Phoenix1o1/ThermoMade/docs/04-control-algorithm.md

# 04 — Control algorithm (specification)

The firmware must implement exactly this. The Python reference implementation lives in
`tools/sim/thermal_sim.py` (`PID`, `PulseModulator`, `TermoMade`), so firmware and simulator
can be checked against each other.

## Layers

```mermaid
flowchart LR
  T["Sensor readings"] --> M["Measurement<br/>plausibility + EMA filter"]
  SP["Setpoint<br/>(mode / schedule)"] --> PI
  M --> PI["PI(D)<br/>u ∈ [0,1]"]
  FF["Feed-forward<br/>(outdoor, future)"] -.-> PI
  PI --> MOD["Pulse modulator<br/>u → ON/OFF targets"]
  MOD --> FSM["Valve FSM<br/>enforces ON_MIN / OFF_MIN"]
  G["Gates: plant hours,<br/>mode OFF, faults"] --> FSM
  FSM --> RELAY["Relay"]
```

`u` is the **demand**: the fraction of time the valve should be open (duty), from 0 to 1.

## 1. Measurement & sensor fusion

- Room node telemetry every 30 s (SHT4x, 0.01 °C). CYD local DS18B20 read every 30 s
  (12-bit, 0.0625 °C).
- **Plausibility:** reject T < 0 °C or > 40 °C, or |ΔT| > 2 °C between consecutive readings.
  Three rejections in a row = sensor failure.
- **Calibration offset** per sensor, set in the UI against a reference thermometer. The room node
  is the reference by default.
- **Learned CYD offset.** The CYD sensor sits in a box with a PSU and an ESP32, so it reads warm by
  a slowly varying amount:
  ```
  if both valid and |dT_room/dt| < 0.5 °C/h:          # quasi-steady only
      off_b += dt/(τ_off+dt) · ((T_base − T_room) − off_b)     τ_off = 6 h
  T_base_corr = T_base − off_b
  ```
  `off_b` is persisted to NVS hourly. Watch it on the diagnostics screen. If it moves a lot with
  the backlight on/off, the sensor chamber needs work.
- **Fusion** (policy `FUSED`): `T = w_r·T_room + (1 − w_r)·T_base_corr`, `w_r = 0.7` default.
  Two sensors in different spots of the big room give a better room average and halve the
  uncorrelated noise.
- **Fallback:** room node lost → `T = T_base_corr` (frozen `off_b`). CYD sensor lost →
  `T = T_room`. Both lost → LIMP (§6).
- **EMA filter** with τ_f = 120 s on the fused value: `Tf += dt/(τ_f+dt) · (T − Tf)`.
- Other policies (bathroom etc.) in [03](03-architecture.md#control-temperature--room-policies).

## 2. PI(D) → demand u

Runs every `TS` = 30 s (fixed tick, real `dt` from a monotonic clock).

```
if SP < SP_prev:  coast = true          # setpoint decreased (e.g. Comfort → Night)
e  = SP − Tf
if e ≥ 0:         coast = false         # room has cooled down to the new setpoint
P  = Kp · e
D  = −Kp · Td · dTf/dt                  # derivative on measurement, low-pass τ = Td/4; Td = 0 by default
u_unsat = P + I + D
if |e| ≤ I_BAND and not coast and not (u_unsat ≥ u_max and e > 0):
    I += Kp · dt / Ti · e               # integrate only near the setpoint
I  = clamp(I, 0, 1)
u  = clamp(P + I + D, 0, u_max)         # u_max = 1, or uc during efficient recovery (§5)
```

- **`I` has a physical meaning:** the duty needed in steady state (the "learned load"). It is
  shown on the diagnostics screen and **persisted to NVS every 30 min** and on mode changes, so a
  power cut does not throw the learning away.
- **Integration band** `I_BAND` = 1.0 °C: no integration on big errors (cold arrival, sun, setback).
  In simulation this cut the cold-arrival overshoot from 0.43 to 0.28 °C with identical
  steady-state results.
- **Coast:** after a setpoint *decrease* the room needs hours to cool down. Without coasting, `I`
  would integrate that negative error and drain the learned load to 0 every night. That makes
  the morning sluggish.
- **Setpoint change:** no derivative kick (D is on the measurement). `I` is kept, so the change is
  bumpless.
- **Mode `AWAY` ↔ `COMFORT`:** keep one `I` per setpoint band (≤ 12 °C vs > 12 °C). The antifreeze
  load is very different from the comfort load. Comfort ↔ Night share one `I`.
- **Integration gated off** when: central plant off, valve forced closed (mode OFF, fault), LIMP
  mode, or BOOST.

## 3. Pulse modulator: u → (ON target, OFF target)

```
uc = ON_MIN / (ON_MIN + OFF_MIN)               # 3/(3+5) = 0.375

u <  U_MIN   (0.03)  → no pulses              (ON —,      OFF ∞)
u ≤  uc              → pulse-FREQUENCY         (ON = ON_MIN, OFF = ON_MIN·(1−u)/u)
u <  U_CONT  (0.90)  → pulse-WIDTH             (ON = OFF_MIN·u/(1−u), OFF = OFF_MIN)
u ≥  U_CONT          → continuous              (ON ∞,      OFF = OFF_MIN)
```

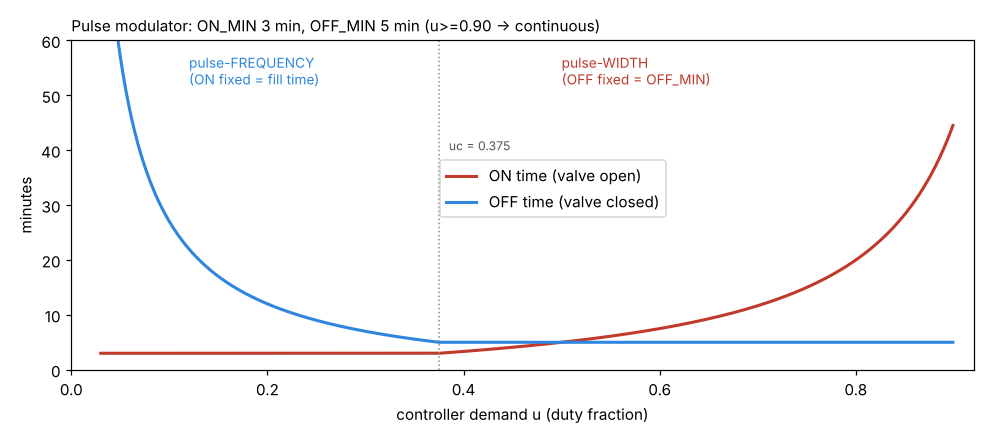
[picture p1: docs/img/modulator.png]
modulator


| u | ON | OFF | Period | Pulses/h |
|---|---|---|---|---|
| 0.05 | 3.0 | 57.0 | 60.0 | 1.0 |
| 0.10 | 3.0 | 27.0 | 30.0 | 2.0 |
| 0.15 | 3.0 | 17.0 | 20.0 | 3.0 |
| 0.20 | 3.0 | 12.0 | 15.0 | 4.0 |
| 0.30 | 3.0 | 7.0 | 10.0 | 6.0 |
| 0.375 | 3.0 | 5.0 | 8.0 | 7.5 |
| 0.50 | 5.0 | 5.0 | 10.0 | 6.0 |
| 0.70 | 11.7 | 5.0 | 16.7 | 3.6 |
| 0.80 | 20.0 | 5.0 | 25.0 | 2.4 |
| ≥ 0.90 | continuous | — | — | — |

(minutes; with ON_MIN = 3, OFF_MIN = 5)

Why this shape: a fill minute buys 3–4× more heat than a keep-open minute ([02](02-heating-physics.md#2-hot-water-in-the-radiators-is-stored-energy-youve-already-paid-for)).
So the modulator **varies frequency first** and stretches ON only when OFF has reached its minimum.

## 4. Valve FSM (the only owner of the relay)

Relay mapping for the 3-point Coster CDK 068: relay **energised** = L on **OPEN** (valve opens),
**de-energised** = L on **CLOSE** (valve closes). The actuator's own limit switches stop the motor
at the ends. The motor takes ~60 s per move, and flow starts around mid-stroke (~30 s).

```mermaid
stateDiagram-v2
  [*] --> CLOSED_LOCKOUT : boot (valve closed)
  CLOSED_LOCKOUT --> CLOSED : t_off ≥ OFF_MIN
  CLOSED --> OPEN : t_off ≥ OFF_target and u ≥ U_MIN and gates OK
  OPEN --> CLOSED_LOCKOUT : t_on ≥ max(ON_MIN, ON_target)
  OPEN --> CLOSED_LOCKOUT : user OFF / fault / plant-off (immediate)
  CLOSED_LOCKOUT : valve closed, OFF_MIN not yet elapsed (no command can open it)
  CLOSED : valve closed, waiting for OFF_target
  OPEN : valve open (billed)
```

Rules:

1. Targets are **re-evaluated every tick** from the current `u`. If the room cools faster, the OFF
   wait shortens (but never below OFF_MIN). If it warms up during a pulse, the pulse still
   completes ON_MIN (the circuit is filled; stopping early saves almost nothing and adds a cycle).
2. **OFF_MIN is absolute.** BOOST, manual ON and setpoint changes all wait for the lockout to
   finish (UI shows "opens in 2:10"). The lockout also applies right after boot, because the
   valve's state before the reboot is unknown.
3. **ON_MIN** applies to every automatic close. Only user OFF, faults and plant-off close earlier.
4. `MAX_CYCLES_PER_HOUR` (default 8) is an extra wear guard: if reached, the next OFF is
   stretched.
5. Every transition is logged with timestamp, reason, `u`, P, I, targets.
6. **Billed-time counter:** accumulate relay-energised seconds. The meter most likely counts from
   the actuator's mid-stroke aux switch, so its ~30 s delay on opening and on closing roughly
   cancels. Daily total persisted at midnight and every 10 min.

Fixes against the legacy sketch: no `forceEvaluate` that toggles regardless of direction, no
forced minimum duty when the room is too warm, and FSM and relay can never disagree
([11](11-legacy-review.md)).

## 5. Recovery: cold start, morning, boost

No special mode is needed to heat a cold house. With Kp = 0.6, an error ≥ 1.5 °C gives P ≥ 0.9,
so the valve stays continuously open. As the error shrinks, `u` drops below U_CONT and
pulse-width, then pulse-frequency, take over. Simulated overshoot after an 8 → 20 °C arrival:
**0.28 °C** (classic thermostat 0.73 °C).

**But continuous ON is the expensive regime under time billing:** the circuit is full, hot water
goes back to the plant, ≈ 0.13 kWh per billed minute instead of ≈ 0.47. Hence two recovery
styles:

| Recovery | Rule | Default for |
|---|---|---|
| **EFFICIENT** | After a setpoint increase, `u_max = uc` (pulse-frequency only, never longer pulses or continuous) until the room is within 0.3 °C. Combined with **optimum start** (begin earlier) | Scheduled Night → Comfort; **arrival after the ARRIVO forced hour** (changed 2026-11-09, see below) |
| **FAST** | `u_max = 1` (continuous allowed) | +/− and manual mode changes (`recovery_user`), BOOST button |

Night setback simulation (Comfort 20 °C 06:30–22:30, outdoor −2 °C; `tools/sim`, section NIGHT
SETBACK):

| Strategy | Billed min/day | Room at 06:30 | Room at 07:30 |
|---|---|---|---|
| Pulse, no setback | **177** | 20.1 | 20.0 |
| Pulse, night 17 °C, fast recovery | 251 (+42 %) | 16.9 | 19.1 |
| Pulse, night 17 °C, efficient, start 2 h early | 212 (+20 %) | 19.3 | 19.5 |
| Pulse, night 18.5 °C, fast | 192 (+8 %) | 18.4 | 19.7 |
| **Pulse, night 18.5 °C, efficient, start 1 h early** | **189 (+7 %)** | **19.6** | **19.8** |
| *Classic thermostat, no setback (≈ today)* | *254* | *20.2* | *20.3* |
| *Classic thermostat, night 17 °C* | *344* | *16.8* | *19.6* |

The model is a heavy building (walls ≈ 2-day time constant), so the night saves only ~3–4 % of
the heat, while the morning recovery costs billed minutes at the worst rate. **Under time
billing a night setback costs money unless it is shallow and recovered efficiently.** Default
plan: Night = 18.5 °C, EFFICIENT recovery, optimum start. If cooler nights matter more than
cost, go to 17 °C and accept ≈ +20 %. Real data will tell: log both for a week each.

The **BOOST** button is a user override (timed continuous ON) and does not touch `I`.

### 5.0 Heating profiles: ECO / BALANCED / PERFORMANCE (2026-11-12, base v0.5)

One choice (touch screen page TEMPERATURE, web page "Profilo riscaldamento") sets how every
warm-up is done, i.e. the three `recovery_*` parameters together:

| Profile | Rule during a warm-up | `recovery_*` |
|---|---|---|
| **ECO** | Pulses only (valve open at most 3 min in 8), however far the room is | 0 |
| **BALANCED (default)** | More than `recovery_wide_c` (1.5 °C) below the setpoint: the valve may stay open. Closer than that: pulses only | 2 |
| **PERFORMANCE** | No limit: the PI may also lengthen the pulses near the setpoint | 1 |

Simulated cold arrival (house 7 °C, outdoor −2 °C, `arrival_study.py`):

| Profile | Reaches 16 °C / 18 °C after | Billed minutes, first 48 h |
|---|---|---|
| ECO (+ ARRIVO's forced hour) | 13.8 h / 18.6 h | 780 |
| BALANCED | 8.9 h / 13.0 h | 1203 (+423) |
| PERFORMANCE | 8.9 h / 13.0 h | 1261 (+481) |

BALANCED warms a cold house as fast as PERFORMANCE and saves about an hour of billed time on the
last 1.5 °C; compared with ECO it costs about **7 billed hours per cold arrival** and is ~5 h
faster. The morning rise (18.5 → 20 °C = 1.5 °C) stays pulse-only in BALANCED, so ordinary days
cost the same as ECO. With BALANCED or PERFORMANCE, ARRIVO's forced hour changes nothing (the
valve is open anyway); it matters in ECO. The three parameters can still be set one by one on
AVANZATE (the profile then shows "personalizzato").

### 5.1 ARRIVO: arriving at the cold house (decided 2026-11-09 with `tools/sim/arrival_study.py`)

The house is kept at 7 °C (VIA). On arrival the family presses **ARRIVO** (the VIA button turns
into ARRIVO while the house is in VIA or OFF):

1. mode → AUTO (schedule setpoint, normally 20 °C);
2. **valve forced open for `arrival_force_min` = 60 min**, ending early as soon as the room is
   within `arrival_stop_c` = 2 °C of the setpoint (so pressing ARRIVO in a house that is already
   warm forces nothing). OFF_MIN still applies: it never reopens the valve early;
3. then normal pulse control with **EFFICIENT** recovery (`recovery_arrival`).

Simulation, arrival 17:00, house and walls at 7 °C, hold 20 °C (`docs/img/arrival_results.txt`,
plot `docs/img/sim_arrival.png`). Outdoor mean −2 °C:

| Strategy | Room after 1 h / 3 h / 6 h | Reaches 16 °C / 18 °C after | Billed min, first 48 h |
|---|---|---|---|
| Classic thermostat (≈ the old one) | 10.8 / 12.4 / 14.4 °C | 8.9 h / 13.0 h | 1427 |
| FAST: continuous until near the setpoint (old default) | 10.8 / 12.4 / 14.4 | 8.9 h / 13.0 h | 1261 (+511) |
| EFFICIENT only (pulses from the start) | 9.9 / 11.2 / 12.7 | 14.2 h / 18.9 h | **750** |
| Forced 30 min + efficient | 10.0 / 11.2 / 12.8 | 14.0 h / 18.8 h | 762 (+12) |
| **Forced 60 min + efficient (chosen)** | **10.8 / 11.3 / 12.9** | **13.8 h / 18.6 h** | **780 (+30)** |
| Forced 120 min + efficient | 10.8 / 11.6 / 13.1 | 13.5 h / 18.4 h | 813 (+63) |
| Forced 240 min + efficient | 10.8 / 12.4 / 13.4 | 12.7 h / 17.8 h | 876 (+126) |

What the numbers say:

- **The building mass sets the pace.** Even with the valve open non-stop it takes ~9 h to reach
  16 °C and ~13 h to reach 18 °C (walls ≈ 30 MJ/K, radiators ≈ 9 kW at most). No valve strategy
  makes a 7 °C house comfortable within an evening.
- **The forced hour is cheap and noticeable early:** +0.9 °C at the 1 h mark and hot radiators at
  once, for about +30 billed minutes per arrival (the pulses would have used ~22 of those 60
  minutes anyway). 30 minutes gives almost nothing at the 1 h mark (the first ~25 min only heat
  the cold circuit); beyond 60 minutes each extra hour costs ~+30 min for ~+0.2 °C.
- **Running continuously until warm (FAST) costs ~8.5 billed hours more per arrival** (+511 min at
  −2 °C, +612 at −8 °C) to be warm ~5 h sooner. That is why the arrival recovery is now EFFICIENT.
  `recovery_arrival = 1` restores the fast behaviour if comfort matters more than cost.
- After the forced hour the air dips ~0.3 °C for a while (pulses deliver less than continuous
  flow). Visible in the plot; harmless.
- Early stop (`arrival_stop_c`): with the house at 18.5 °C, forcing 60 min would overshoot to
  20.6 °C and add 27 billed minutes; with the 2 °C stop nothing is forced.

**The real fix for a cold arrival is a planned return** (not built yet, decision D23): heat
before arriving. Same model, outdoor −2 °C, billed minutes over 24 h before to 48 h after arrival:

| Plan | Room at arrival | Room 3 h later | Billed min (extra vs cold arrival) |
|---|---|---|---|
| Arrive cold, efficient | 7.0 °C | 11.5 °C | 789 |
| Arrive cold, ARRIVO 60 min | 7.0 | 11.7 | 819 (+30) |
| Arrive cold, FAST | 7.0 | 12.7 | 1279 (+490) |
| Start heating 12 h before, efficient | 16.1 | 17.4 | 870 (+81) |
| **Start 18 h before, efficient** | **18.2** | **19.4** | **897 (+108)** |
| Start 24 h before, efficient | 19.8 | 20.1 | 926 (+137) |

Arriving at 18 °C costs about 1.8 billed hours more than arriving cold, and **6.4 billed hours
less than the FAST cold arrival**. Without internet it needs the return date set before leaving
("VIA fino al …" on the CYD, or later from the phone app on site).

## 6. Fallback / LIMP

Chain: fused → room node only → CYD sensor only (frozen learned offset) → LIMP.
When no valid control temperature exists ([03](03-architecture.md#failure-modes--reactions)):
`u = clamp(I_learned, 0.05, 0.30)`, or 0.15 if `I` was never learned. The modulator and FSM run
as usual. Alarm on screen, LED purple, short beep every 10 min. `FAIL_OFF` policy is available
for summer or if you prefer. Default = LIMP, because an unattended mountain house must not freeze.

## 7. Parameters (defaults)

| Name | Default | Range | Notes |
|---|---|---|---|
| `ON_MIN` | 180 s | 60–600 | Circuit fill time. Measure it (Phase 0) |
| `OFF_MIN` | 300 s | 180–1800 | Valve close + stabilisation |
| `TS` | 30 s | — | Controller tick |
| `TAU_F` | 120 s | 30–600 | Measurement EMA |
| `KP` | 0.6 /°C | 0.2–1.5 | Duty per °C of error |
| `TI` | 120 min | 30–300 | Integral time |
| `TD` | 0 | 0–20 min | Off by default (sim: no benefit) |
| `U_MIN` | 0.03 | 0–0.1 | Below this: no pulses |
| `U_CONT` | 0.90 | 0.8–1.0 | Above this: continuous |
| `I0` | 0.15 | 0–1 | Initial learned duty (first boot only) |
| `STALE_S` | 300 s | 120–900 | Node considered lost |
| `LIMP_U` | learned I clamped 0.05–0.30 | — | Fallback demand |
| `MAX_CYCLES_PER_HOUR` | 8 | 4–12 | Wear guard |
| `SP_COMFORT` / `SP_NIGHT` / `SP_AWAY` | 20.0 / 18.5 / 7.0 °C | 5–25 | Setpoints are always clamped to 5–25 °C. Night 18.5 trade-off in §5 |
| `I_BAND` | 1.0 °C | 0.3–3 | Integrate only when abs(e) ≤ I_BAND |
| `RECOVERY_SCHED` / `RECOVERY_ARRIVAL` / `RECOVERY_USER` | all **BALANCED** | 0 eco, 1 perf, 2 bal | Set together by the heating profile (§5.0) |
| `RECOVERY_WIDE_C` | 1.5 °C | 0.5–5 | BALANCED: valve may stay open when further than this below the setpoint |
| `ARRIVAL_FORCE_MIN` | 60 min | 0–240 | ARRIVO forced heating; 0 = ARRIVO only switches to AUTO (§5.1) |
| `ARRIVAL_STOP_C` | 2.0 °C | 0.5–10 | Forced heating ends once T ≥ setpoint − this |
| `PREHEAT_MAX` | 3 h | 0–6 h | Optimum-start limit. Fixed 1 h until learned |
| Default schedule | Comfort 06:30–22:30, Night otherwise | — | Weekly, up to 4 slots/day, copy-day function |
| `W_ROOM` | 0.7 | 0–1 | Fusion weight of the room node vs the CYD sensor |
| `TAU_OFF` | 6 h | 1–24 h | Learning time constant of the CYD sensor offset |
| `CONT_WARN_S` | 4 h | — | Continuous-ON warning |
| `BUDGET_MIN_DAY` | 0 (off) | — | Daily billed-minutes alarm |

All parameters can be edited on the CYD hidden page AVANZATE (and the serial console `set`;
later the web UI), are stored in NVS. Firmware names, steps and exact clamping ranges:
[07 "Hidden settings"](07-user-interface.md#hidden-settings-long-press-the-clock-2-s).

## 8. Tuning procedure (on site)

1. **Measure the fill time** (Phase 0): touch the far radiator's return pipe, or better, log a
   DS18B20 on it. Time from valve command to the moment the return gets hot = `ON_MIN`.
2. Start with the defaults. Run 3 days.
3. Read the diagnostics: if `I` keeps drifting for days, Ti is fine. If the temperature
   oscillates with a period of hours, increase `TI` (150–180 min). If recovery after setpoint
   steps is slow, increase `KP` (0.8).
4. If the room ripples more than ±0.3 °C in mild weather: that is the fill-quantum limit. Consider
   a shorter `ON_MIN` on mild days (future "partial fill").
5. Feed the logs into the simulator (`tools/sim`) to calibrate the plant model, then re-tune there
   first.

## 9. Planned extensions

- **Outdoor feed-forward** (needs outdoor node): `u = u_ff + PI`, with
  `u_ff = K_ff · max(0, SP − T_out)`. `K_ff` is learned slowly as EMA of `I/(SP − T_out)` during
  stable periods. Faster reaction to weather changes, smaller `I` swings.
- **Adaptive fill time** (needs pipe node): end each pulse when the return pipe temperature rises
  by more than 10 K over its pre-pulse value (hot front arrived), bounded to
  [ON_MIN_LOW, ON_MIN_HIGH]. Learn the median as `ON_MIN`.
- **Plant-off detection** (pipe node): supply < 35 °C after 60 s open → close, pause pulses for
  15 min, freeze `I`.
- **Overshoot learning** after continuous-ON periods: lower `U_CONT` exit margin if overshoot
  repeats.
- **Optimum start** (works offline): learn the morning warm-up rate (°C/h, vs outdoor temperature
  when the outdoor node exists) and start the Night → Comfort transition early enough that the
  room is at Comfort *at* the scheduled time, not 1–2 h later. Same for a planned
  `AWAY → COMFORT` date entered before leaving ("we arrive Friday 18:00").
