Phoenix1o1/ThermoMade/docs/img/sim_arrival.png

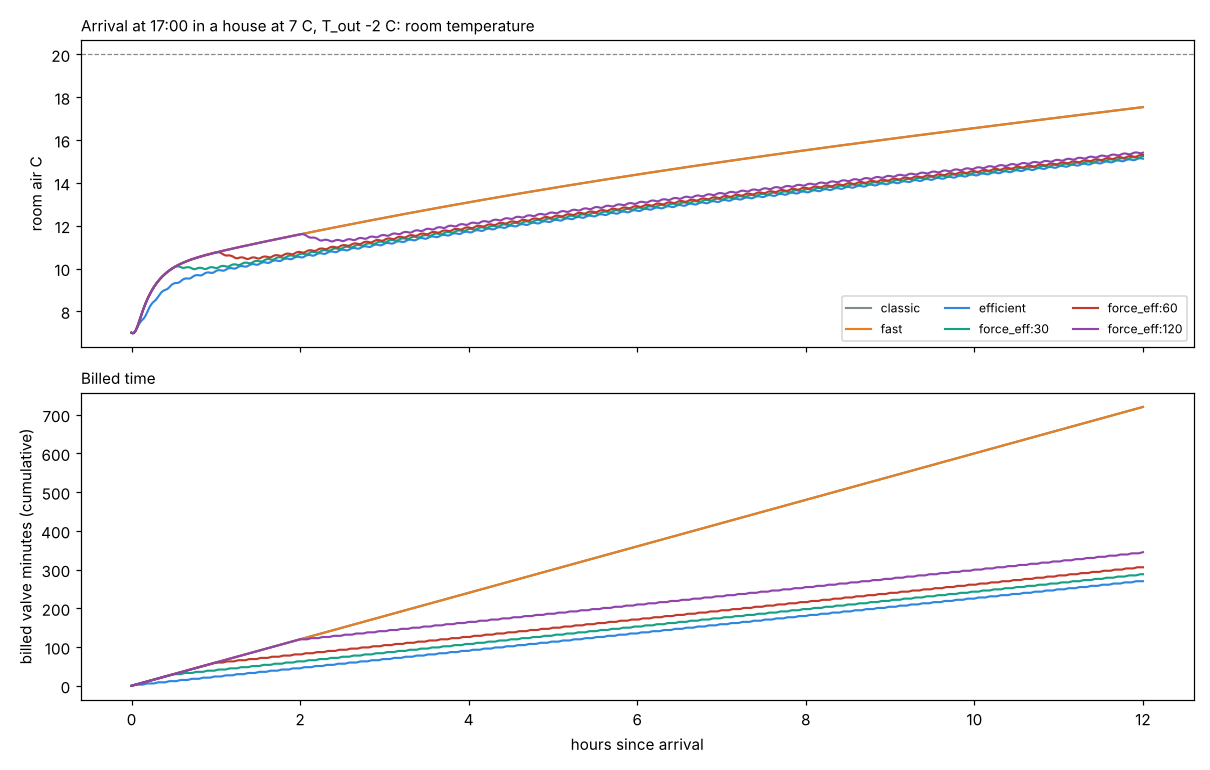
docs/img/sim_arrival.png
