Phoenix1o1/ThermoMade/hardware/enclosures/stl/termomade_base_print.stl

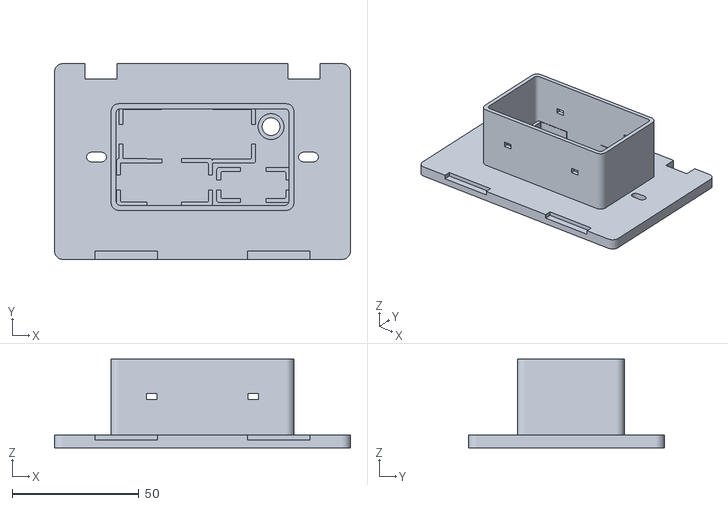
[picture p26: CAD file, 2026-11-09]
hardware/enclosures/stl/termomade_base_print.stl
116.6 x 77.1 x 35.0
