Phoenix1o1/ThermoMade/hardware/enclosures/stl/termomade_front_print.stl

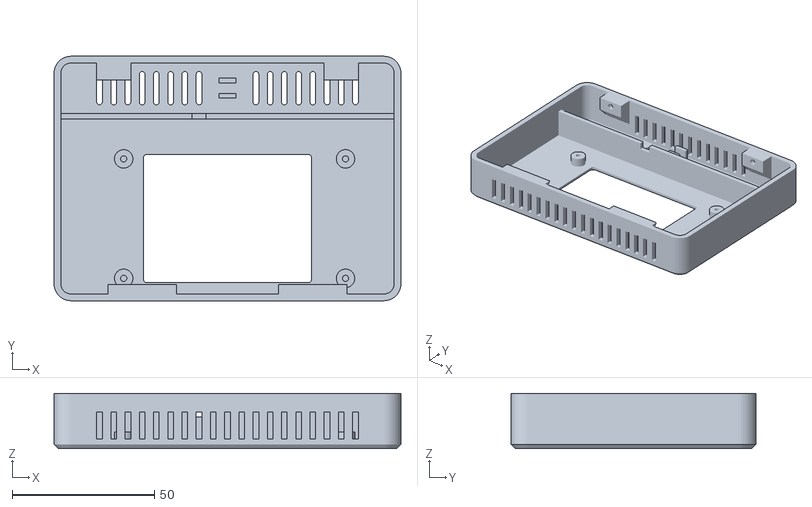
[picture p27: CAD file, 2026-11-09]
hardware/enclosures/stl/termomade_front_print.stl
122.0 x 86.0 x 19.5
