Phoenix1o1/ThermoMade/hardware/enclosures/stl/termomade_fit_test.stl

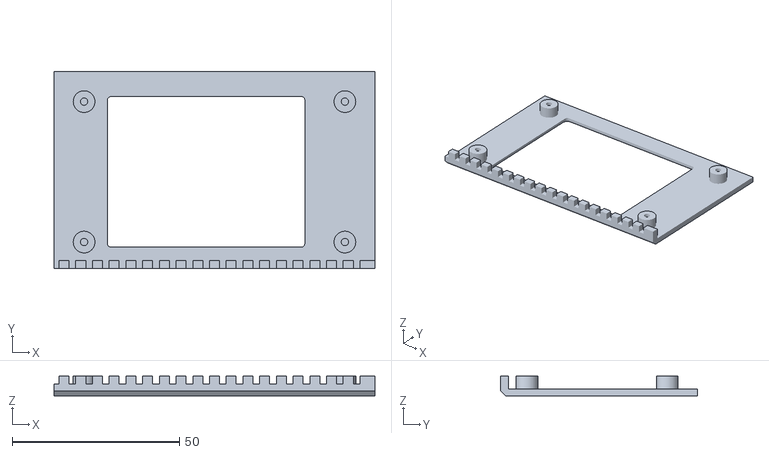
[picture p28: CAD file, 2026-11-09]
hardware/enclosures/stl/termomade_fit_test.stl
96.0 x 58.9 x 5.90
