Phoenix1o1/ThermoMade/docs/img/fast_house_results.txt

=== default model: arrival at 17:00, house 7 C, outdoor -2 C ===
  profile        T1h        T3h        T6h      t16_h      t18_h    billed6   billed48  overshoot    extra48
      ECO       9.88      11.16      12.70      14.20      18.88        135        750       0.25          0
ECO + ARRIVO 60'      10.75      11.33      12.91      13.83      18.63        171        780       0.25         30
 BALANCED      10.75      12.37      14.39       8.90      12.95        359       1203       0.25        453
PERFORMANCE      10.75      12.37      14.39       8.90      12.95        359       1261       0.30        511

=== hotter water (85 C supply): arrival at 17:00, house 7 C, outdoor -2 C ===
  profile        T1h        T3h        T6h      t16_h      t18_h    billed6   billed48  overshoot    extra48
      ECO      10.46      12.00      13.89      10.07      14.22        135        603       0.43          0
ECO + ARRIVO 60'      11.52      12.21      14.14       9.58      13.85        171        633       0.42         30
 BALANCED      11.52      13.47      15.93       6.10       9.03        359        926       0.42        323
PERFORMANCE      11.52      13.47      15.93       6.10       9.03        359        966       0.42        363

=== radiators x1.5: arrival at 17:00, house 7 C, outdoor -2 C ===
  profile        T1h        T3h        T6h      t16_h      t18_h    billed6   billed48  overshoot    extra48
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
 BALANCED      16.38      19.81      19.62       0.92       1.38        143        356       1.01         41
PERFORMANCE      16.38      20.04      20.08       0.92       1.38        150        360       1.01         45
