Phoenix1o1/ThermoMade/docs/img/arrival_results.txt

=== ARRIVAL at 17:00, house at 7 C, T_out mean -8 C (+-5), hold 20 C, 48 h (learned duty I = 0.183) ===
 strategy        T1h        T3h        T6h      t16_h      t18_h  deficit_Ch    billed6   billed48  overshoot    extra48
  classic      10.33      11.77      13.55      11.32      15.93       74.69        359       1761       0.76        803
     fast      10.33      11.77      13.55      11.32      15.93       74.69        359       1570       0.29        612
efficient       9.46      10.55      11.84      18.20      23.57       94.52        135        958       0.19          0
force_eff:15       9.52      10.59      11.92      18.02      23.48       93.63        144        964       0.17          6
force_eff:30       9.60      10.61      11.98      17.98      23.45       92.95        153        978       0.18         20
force_eff:60      10.33      10.72      12.05      17.83      23.30       91.66        171        989       0.17         31
force_eff:90      10.33      10.87      12.09      17.67      23.13       90.41        189       1007       0.17         49
force_eff:120      10.33      10.95      12.19      17.50      22.97       89.22        209       1022       0.17         64
force_eff:180      10.33      11.77      12.40      17.17      22.65       86.95        246       1052       0.17         94
force_eff:240      10.33      11.77      12.54      16.83      22.42       84.87        284       1085       0.17        127
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
start 24 h before, efficient      18.11      18.93      19.43        3.82            540          1228        197
start 12 h before, fast      17.13      18.53      19.25        7.06            766          1724        693

=== PLANNED RETURN vs ARRIVING COLD, T_out mean -2 C: window = 24 h before to 48 h after arrival (17:00) ===
     plan  T_arrival        T3h        T6h  deficit_Ch  billed_before  billed_total      extra
cold arrival, efficient       7.03      11.50      12.99       80.84             48           789          0
cold arrival, efficient, force 60'       7.03      11.68      13.20       78.02             48           819         30
cold arrival, fast       7.03      12.69      14.68       61.46             48          1279        490
start 6 h before, efficient      13.34      14.94      16.11       42.48            177           825         36
start 12 h before, efficient      16.10      17.44      18.37       15.37            300           870         81
start 18 h before, efficient      18.24      19.37      19.91        2.07            420           897        108
start 24 h before, efficient      19.82      20.10      20.01        0.00            536           926        137
start 12 h before, fast      18.49      19.59      20.11        1.46            750          1296        507

plot written to ../../docs/img/sim_arrival.png
