Phoenix1o1/ThermoMade/(commit log)

2026-11-09 Phase 0: plan, knowledge base and thermal simulator
    - docs/01-11: requirements, heating physics & billing, architecture,
    control algorithm spec (PI + pulse modulator + valve FSM), hardware
    (CYD pin map, relay, bypass, sensors, BOM), ESP-NOW protocol, UI,
    software stack, logging/A-B evaluation, roadmap with open decisions,
    review of the legacy Termostato.ino
    - tools/sim: Python thermal model comparing classic thermostat, TPI and
    the TermoMade pulse controller; plots in docs/img
    - CLAUDE.md: context and hard rules for AI-assisted sessions
    Claude-Session: https://claude.ai/code/session_01K3Phny9T7yLpC2aSnG1JV6
2026-11-09 Fold in site answers: Coster 3-point valve, offline house, sensor fusion, app, enclosure
    - Valve: Coster CDK 068 230 V 3-point -> single SPDT relay (NO=open, NC=close)
    - Billing: yearly fuel split by hours x m2 (pure time) -> savings are real
    - No internet: AP-only, DS3231 RTC on the room node + phone time sync
    - Second temperature sensor (DS18B20) on the CYD, fused with learned offset
    - Night schedule; simulation shows deep setbacks raise billed time under
    time billing -> efficient (pulse-only) recovery + shallow default night
    - PID: integration band + coast after setpoint decreases (sim + docs)
    - Screen off after 30 s; Italian parent UI; docs/12 Android app plan;
    docs/13 2-part OpenSCA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
2026-11-09 Enclosure v1: parametric 2-part OpenSCAD box on the 503 wall box
    - hardware/enclosures/termomade_box.scad: front shell (window, CYD on 4
    standoffs, sensor chamber with TO-92 cradle, vents, hook lips, lock
    bosses) + base (plate on 503 screws, mains pocket with PSU/relay/
    terminal cradles, LV sleeve). Customizer parameters, views, print parts
    - CYD geometry from the Sunton drawing + community STEP model
    - CAD-checked: no interference assembled or along the slide-on path,
    both parts print without supports
    - STLs (fit test, front, base) and renders; docs/13 rewritten
    - D5 answered: 2-USB CYD (ST7789)
    Claude-Session: https://claude.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
    [termomade_base_print.stl, termomade_box.scad, termomade_fit_test.stl, termomade_front_print.stl]
2026-11-09 Firmware v0.1: base (CYD), room node, control library and native tests
    - lib/tm_control: pure C++17 thermostat (PI + pulse modulator + valve FSM with
    absolute OFF_MIN and boot lockout, sensor fusion with learned CYD offset,
    schedule with efficient recovery, LIMP, humidity advice, events). Golden
    vectors from the Python simulator match tick for tick.
    - lib/tm_protocol (ESP-NOW frames v1), lib/tm_util (CRC, SHT4x/DS3231, dates).
    - Base: control task owns controller + settings + relay (task watchdog),
    request queue / snapshot between tasks, NVS blobs with CRC, DS18B20, ESP-NOW
    pairing and ACKs with time, Italian Home + Diagnostics screens (LovyanGFX,
    screen off after 30 s, first tou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
    [partitions_base.csv]
2026-11-09 Base v0.2: ARRIVO button, hidden settings pages, LDR light sensing
    - ARRIVO (decided by simulation, tools/sim/arrival_study.py): the VIA button
    becomes ARRIVO while away; it switches to AUTO and forces the valve open for
    60 min (ends early within 2 C of the setpoint), then pulse-only recovery.
    Controller::arrive() + params arrival_force_min / arrival_stop_c;
    recovery_arrival default now EFFICIENT (continuous until warm cost ~8.5
    billed hours more per arrival in the model). OFF_MIN still absolute.
    Mirrored by ForcedStart in thermal_sim.py; 2 new golden scenarios, 4 unit
    tests, arrive() added to the 20-day hard-rule fuzz test (46 tests).
    - Hidden settings (long-press the clock 2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
2026-11-11 OFF button on Home (two taps), CI workflow, log analysis tool
    - Home: OFF in the top bar, second tap within 3 s confirms (D26).
    - .github/workflows/ci.yml: native tests, firmware builds, golden check, UI render.
    - tools/analysis: tm_logs.py (summary/plot/fit/compare) + fake log generator.
    - Docs: 07, 09, 10 (D26, D27).
    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
2026-11-11 Fix audit findings: wrap-safe deadlines, boost limits, sensor fault handling
    - tmu::Deadline replaces (int32)(until-now) tests that re-armed after 24.9 days.
    - Boost ends on OFF/AWAY and at setpoint + 2 C; no forced heating without a sensor.
    - Fusion: stale sensors latched, median reset, colder sensor wins on disagreement.
    - Settings: net_id and mode kept in their own NVS keys; node returns to HELLO
    after 10 reports without the base's ACK.
    - 2 new tests (48). Audit summary and open items in docs/10.
    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
    [main.cpp, settings.cpp, ui.cpp, ui_menu.cpp]
2026-11-11 Base v0.4: firmware update from the web page, pairing and room offset, one-command checks
    - /api/update: upload firmware.bin to the spare OTA slot, validated, reboot via the control task.
    - Web: Sensori section (state, pairing), room_offset_c calibration parameter (43 params).
    - tools/check.sh: every check with one PASS/FAIL line each; web page browser test
    (tools/web_mock/test_page.py) also in CI.
    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
    [base_config.h, param_table.h, settings.cpp, web.cpp]
2026-11-11 Room node: SHT31-D build (node_sht31); record D13, D18, D29
    SHT3x 16-bit commands and humidity formula on the SHT4x I2C path, decode test.
    Relay: selectable module, jumper on H. Neutral will be brought to the box.
    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
2026-11-11 Base v0.5: heating profiles ECO / BALANCED / PERFORMANCE (default BALANCED)
    Recovery::Balanced: no cap while more than recovery_wide_c (1.5 C) below the
    setpoint, pulses only when closer. Profile selector on the TEMPERATURE page and
    the web page sets the three recovery_* parameters. Mirrored in the simulator,
    new golden scenario, unit test (51 tests). check.sh golden step compares
    against the working tree.
    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
2026-11-11 Stage fast-house arrival study (not run yet)
    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
2026-11-12 Record house details for simulator calibration (D31)
    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
